CGShepherd/Phoenix/README_STAGE3A.md

# Project Phoenix — Architecture C Stage 3A protection predesign

Run the three LTspice decks in numeric order and paste all three Error Logs.

This pack does not yet select a fuse or SCR. It first resolves the branch resistor
and fault-current window so that fuse/crowbar selection can be coordinated rather
than guessed.
