CGShepherd/Phoenix/README_STAGE3D.md

# Project Phoenix — Stage 3D final clamp batch

Extract into the repository root and run:

    tools\run_stage3d_batch.bat

Return:

    test\results\stage3d_batch\PHX_STAGE3D_MASTER.log

If this batch passes, the Architecture C protection stack can be frozen for schematic
capture and bench validation.
