CGShepherd/Phoenix/README_ARCH_C_CLOSURE.md

# Project Phoenix — Architecture C closure pack

This pack closes the exploratory Architecture C LTspice phase and prepares the branch
for schematic/component implementation.

Files:

- `electronics/calculations/architecture_c_baseline.md`
- `electronics/design/architecture_c_component_baseline.md`
- `electronics/design/ADR-PHX-ARCH-C-001.md`
- `test/procedures/PHX-TV-008-hardware-validation.md`

Recommended workflow:

1. extract into repository root;
2. run `git status --short`;
3. inspect the new files;
4. stage and commit them as the Architecture C baseline closure;
5. proceed to schematic implementation and exact manufacturer part-number selection.

Suggested commit message:

    docs(power): baseline Architecture C preregulator and protection

Do not delete the existing Stage 1/2/3 test decks; they remain verification evidence.
