CGShepherd/Phoenix/MANIFEST.md

# Stage 2 pack manifest

- `README_STAGE2_PACK.md` — 2228 bytes
- `electronics/calculations/architecture_c_first_pass.md` — 5287 bytes
- `electronics/spice/PHX_ARCH_C_stage2_regulator_template.cir` — 3304 bytes
- `electronics/spice/models/README.md` — 1862 bytes
- `electronics/spice/models/ti/.gitkeep` — 0 bytes
- `test/procedures/PHX-TV-001-ltspice-architecture-c.md` — 6828 bytes
- `test/results/PHX_ARCH_C_stage2_results_template.csv` — 254 bytes
- `tools/inspect_spice_subckts.py` — 2605 bytes
- `tools/prepare_stage2_models.bat` — 1466 bytes
