CGShepherd/Phoenix/docs/archive/PHOENIX_PRE_SSD_DISPOSITION_20261023/README.md

# Phoenix historical preregulator evidence

Status: HISTORICAL FILE COPIES HASH-VERIFIED.
Git commit, GitHub push and independent recovery ZIP pending.

This archive preserves 67 original Phoenix parent-directory
files, including historical netlists, logs, circuit evidence,
engineering documents and implementation packages.

The manifest records all 80 original top-level files,
their sizes, SHA-256 hashes and archival dispositions.

Thirteen generated bulk numerical outputs are excluded
from the planned recovery ZIP, but remain in the original
Phoenix directory until a separate deletion decision.

The former bespoke negative-regulator approach is
superseded by Architecture C. Not every previous
experimental revision is asserted to have failed.

The current Architecture C verification evidence remains
part of the planned recovery ZIP.

No original files were deleted in this transaction.
No Git changes were staged, committed or pushed.

SSD replacement clearance: NOT GRANTED.
