CGShepherd/Phoenix/test/procedures/PHX-TV-007-stage3d-fuse-i2t-closure.md

# PHX-TV-007 — Stage 3D fuse I2t closure

Objective: correct the Stage 3D fuse-current integration error and produce the final
current-squared-time evidence required for protection sign-off.

Acceptance:
- I2t must scale with the square of the measured fault current and with time;
- values must differ appropriately across 48/55/60/62 V source corners;
- compare final results with the chosen fuse's manufacturer melting-I2t data before
  declaring protection frozen.
