CGShepherd/Phoenix/test/results/PHX_ARCH_C_first_pass.csv

step | vraw_v | load_mA | vz_corner_v | vpre_pos_avg_v | vpre_neg_avg_v | vpre_pos_pp_mV | vpre_neg_pp_mV | vout_pos_avg_v | vout_neg_avg_v | iz_pos_avg_mA | iz_neg_avg_mA | iq_pos_avg_mA | iq_neg_avg_mA
1 | 48.0 | 0.0 | 22.8 | 22.223143360 | -22.223143360 | 6.269455 | 6.269455 | 17.000000 | -17.000000 | 6.238680 | 6.238680 | 10.196864 | 10.196864
2 | 55.0 | 0.0 | 22.8 | 22.233267940 | -22.233267940 | 5.266190 | 5.266190 | 17.000000 | -17.000000 | 8.045555 | 8.045555 | 10.211022 | 10.211022
3 | 60.0 | 0.0 | 22.8 | 22.239573715 | -22.239573715 | 4.774094 | 4.774094 | 17.000000 | -17.000000 | 9.335334 | 9.335334 | 10.220069 | 10.220069
4 | 48.0 | 4.7 | 22.8 | 22.212905037 | -22.212905037 | 6.362915 | 6.362915 | 17.000000 | -17.000000 | 6.138573 | 6.138573 | 14.796624 | 14.796624
5 | 55.0 | 4.7 | 22.8 | 22.223158032 | -22.223158032 | 5.323410 | 5.323410 | 17.000000 | -17.000000 | 7.951934 | 7.951934 | 14.817300 | 14.817300
6 | 60.0 | 4.7 | 22.8 | 22.229525230 | -22.229525230 | 4.816055 | 4.816055 | 17.000000 | -17.000000 | 9.245860 | 9.245860 | 14.830508 | 14.830508
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
