CGShepherd/Phoenix/(commit log)

2026-08-21 chore: initialise Project Phoenix Architecture C baseline
    [PHX_ARCH_C_first_pass.csv]
2026-08-21 docs(calc): update Architecture C regulator current budget
2026-08-21 refactor(spice): model Architecture C preregulator current and tolerance
2026-08-21 test(spice): record Architecture C first-pass sweep
    [PHX_ARCH_C_first_pass.csv]
2026-08-25 test(spice): prepare Architecture C Stage 2 verification
    [PHX_ARCH_C_stage2_results_template.csv]
2026-08-25 docs(power): baseline Architecture C preregulator and protection
2026-08-25 docs(power): down-select Architecture C implementation components
    [architecture_c_bom.csv]
2026-10-24 Archive superseded Phoenix regulator evidence before SSD replacement
